nkowitt/ECrypt_analog_arms_control/README.md

# ECrypt_analog_arms_control
Design documentation for the analog information barrier circuit and data described in Warhead Verification with Neutron Beams and an
Analog Information Barrier.
