nkowitt/ECrypt_analog_arms_control/ECrypt_RevC.pdf

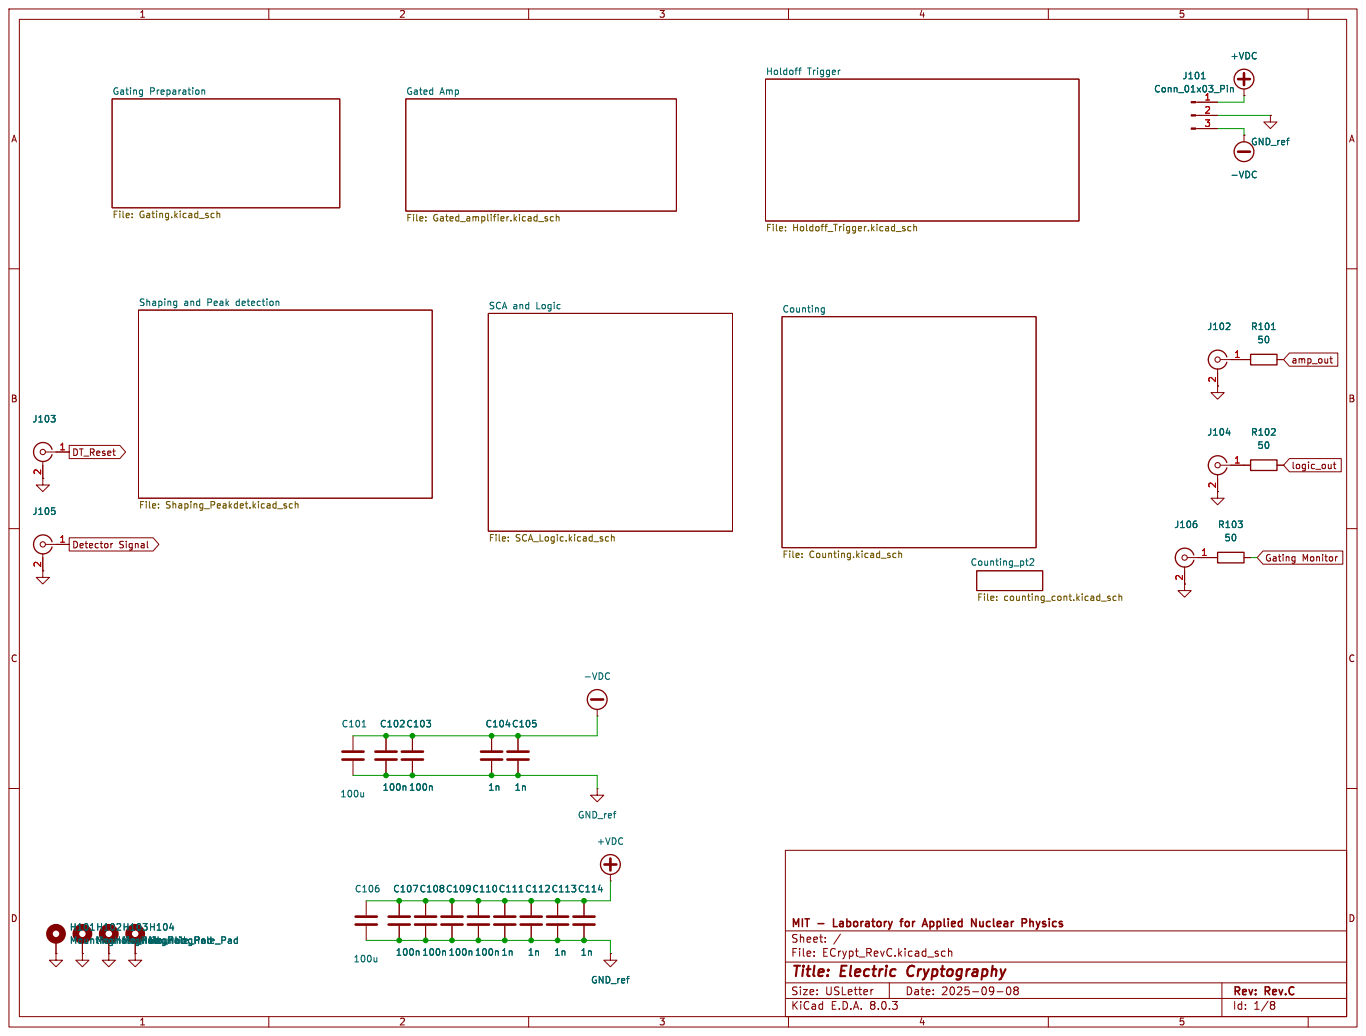
[picture p1: page 1]

Gating Preparation File: Gating.kicad_sch

Counting File: Counting.kicad_sch SCA and Logic File: SCA_Logic.kicad_sch

Id: 1/8 Title: Electric Cryptography

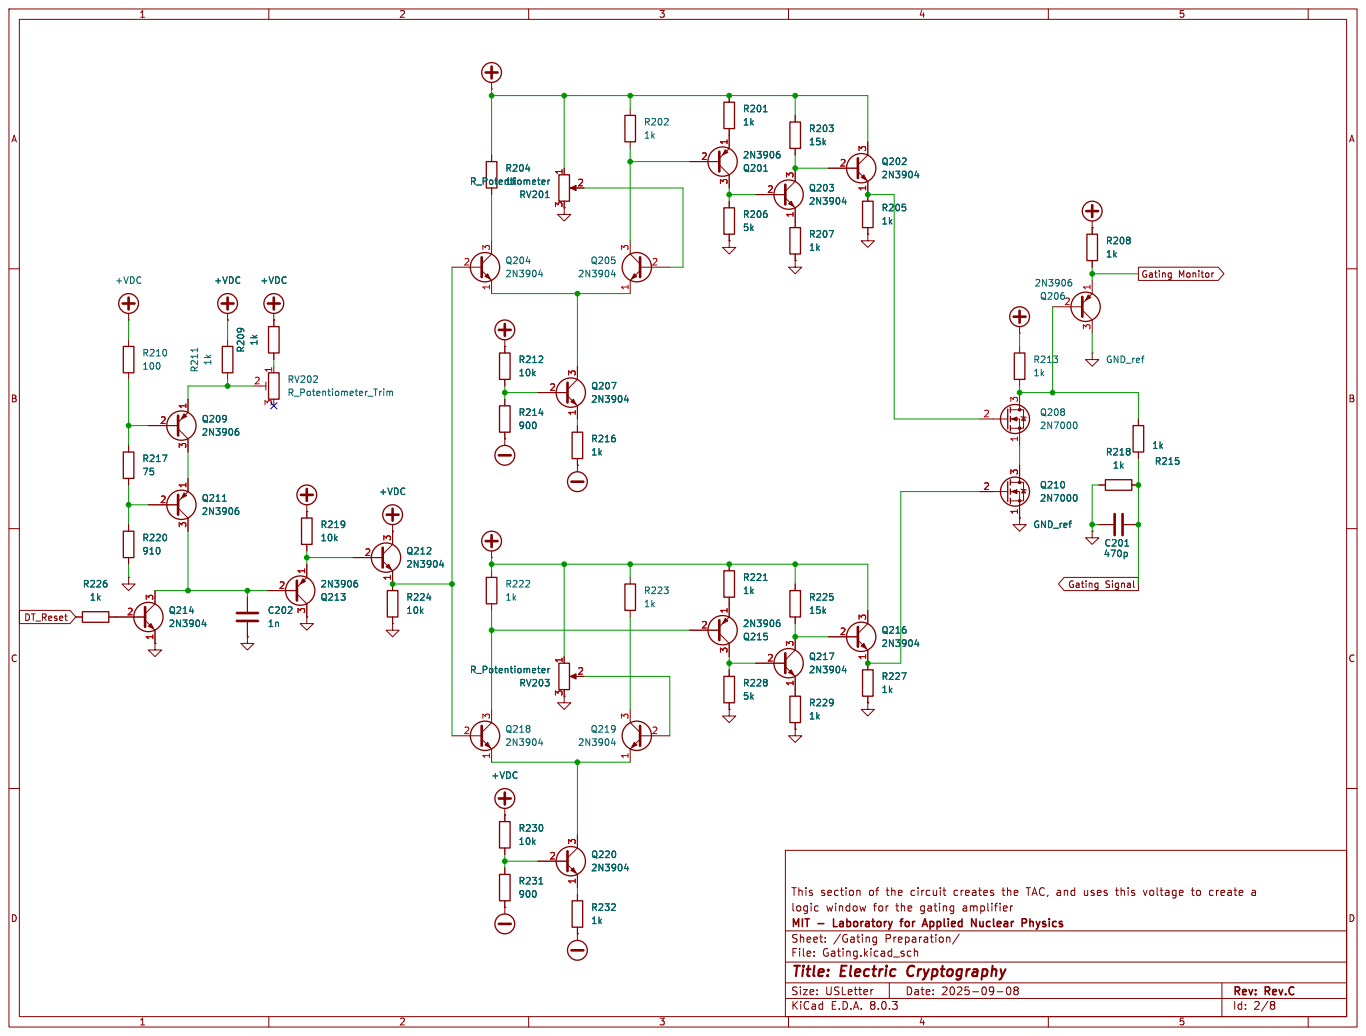
[picture p2: page 2]

Id: 2/8 Title: Electric Cryptography

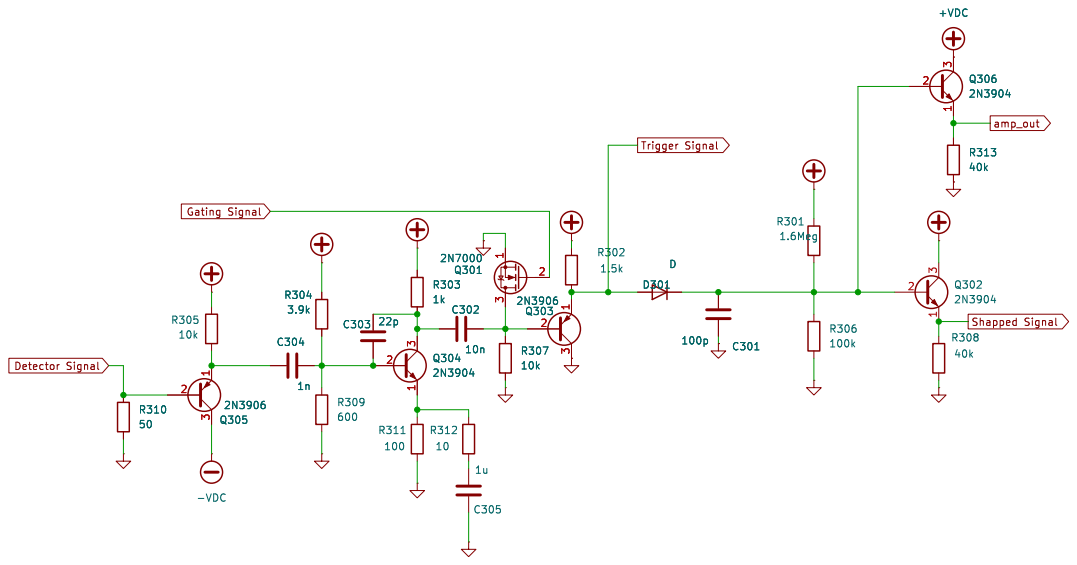
[picture p3: page 3]

Id: 3/8 Title: Electric Cryptography

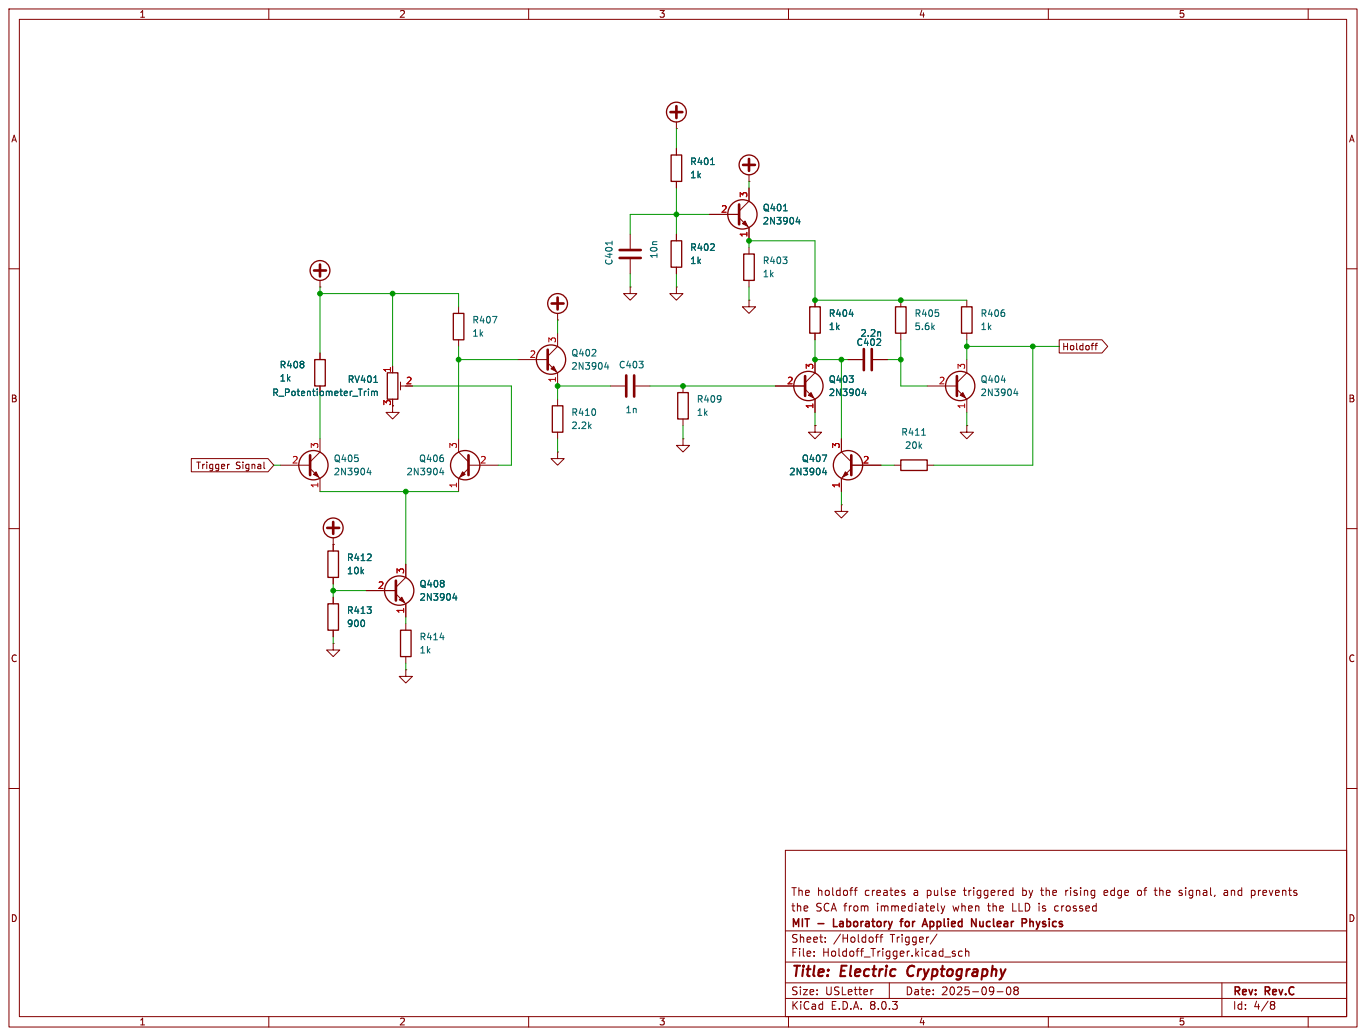
[picture p4: page 4]

Id: 4/8 Title: Electric Cryptography

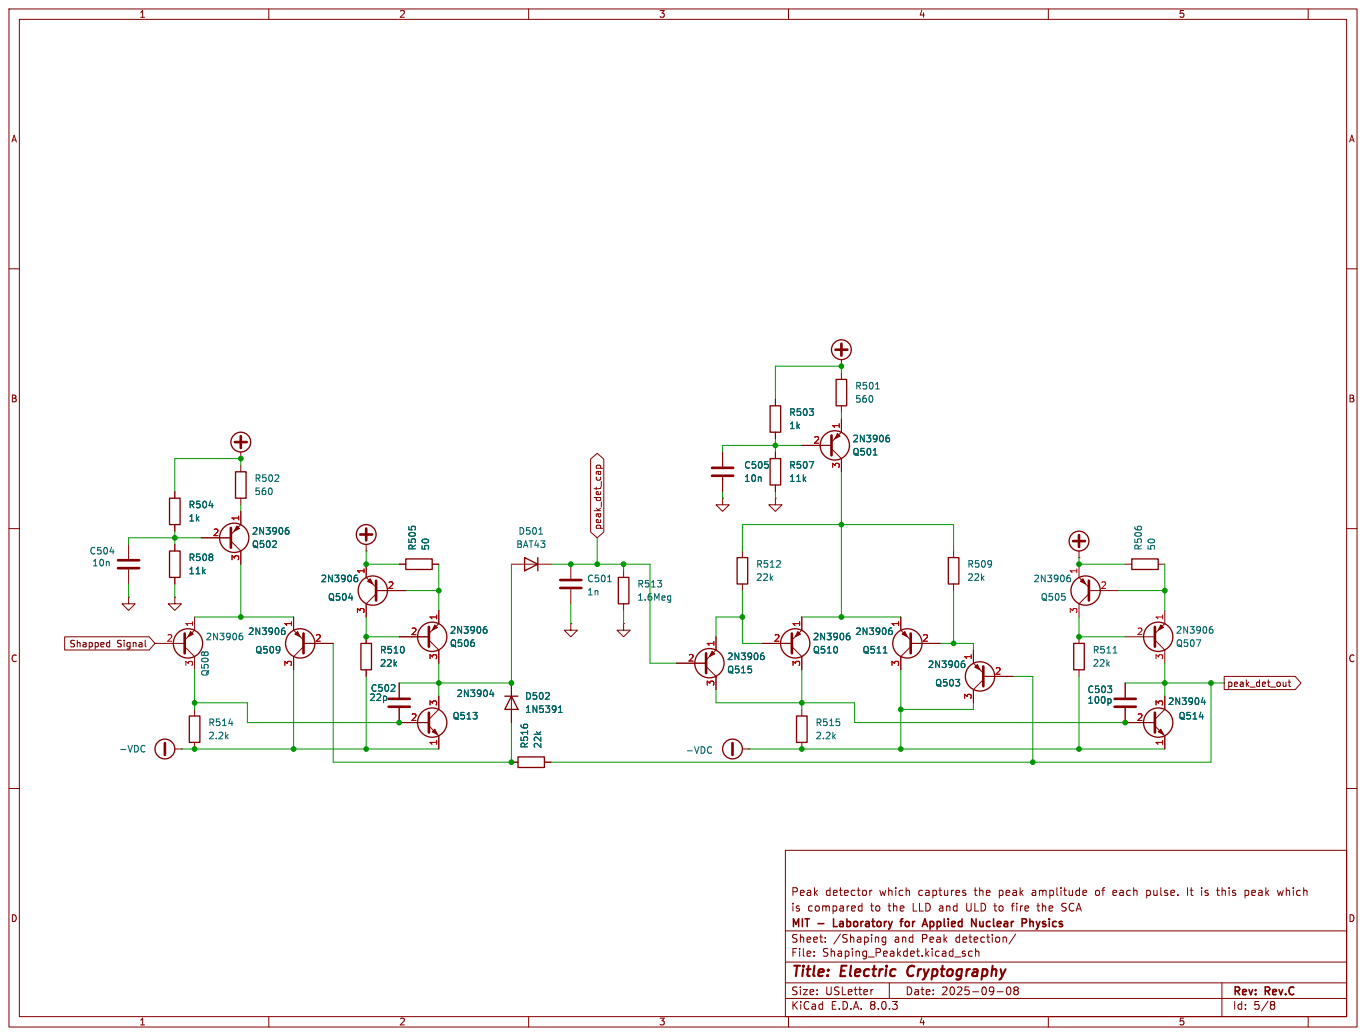
[picture p5: page 5]

Id: 5/8 Title: Electric Cryptography

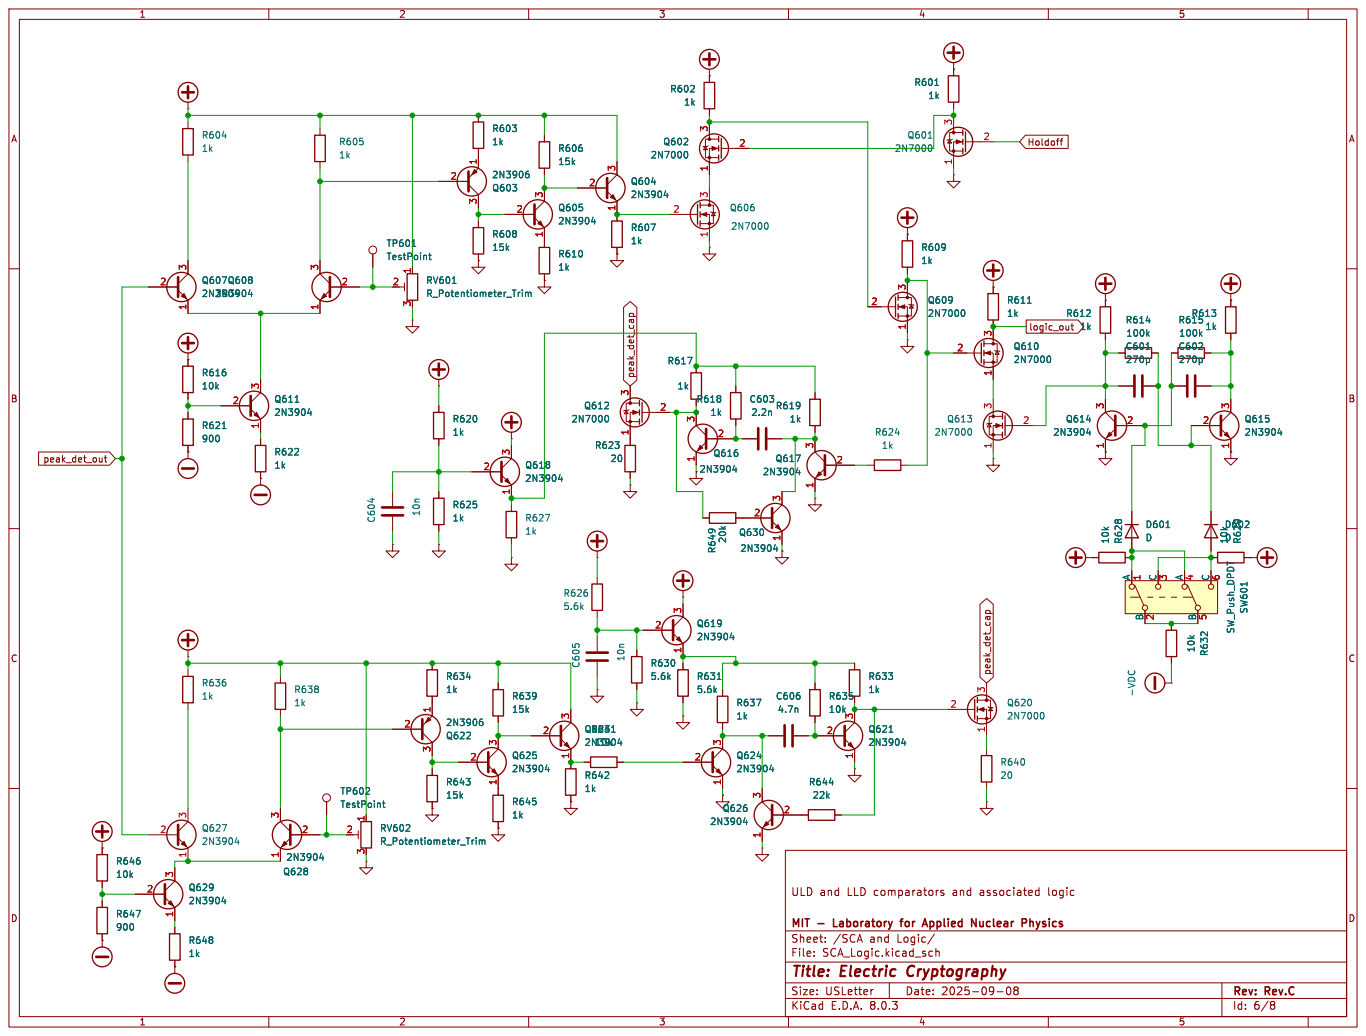
[picture p6: page 6]

Id: 6/8 Title: Electric Cryptography

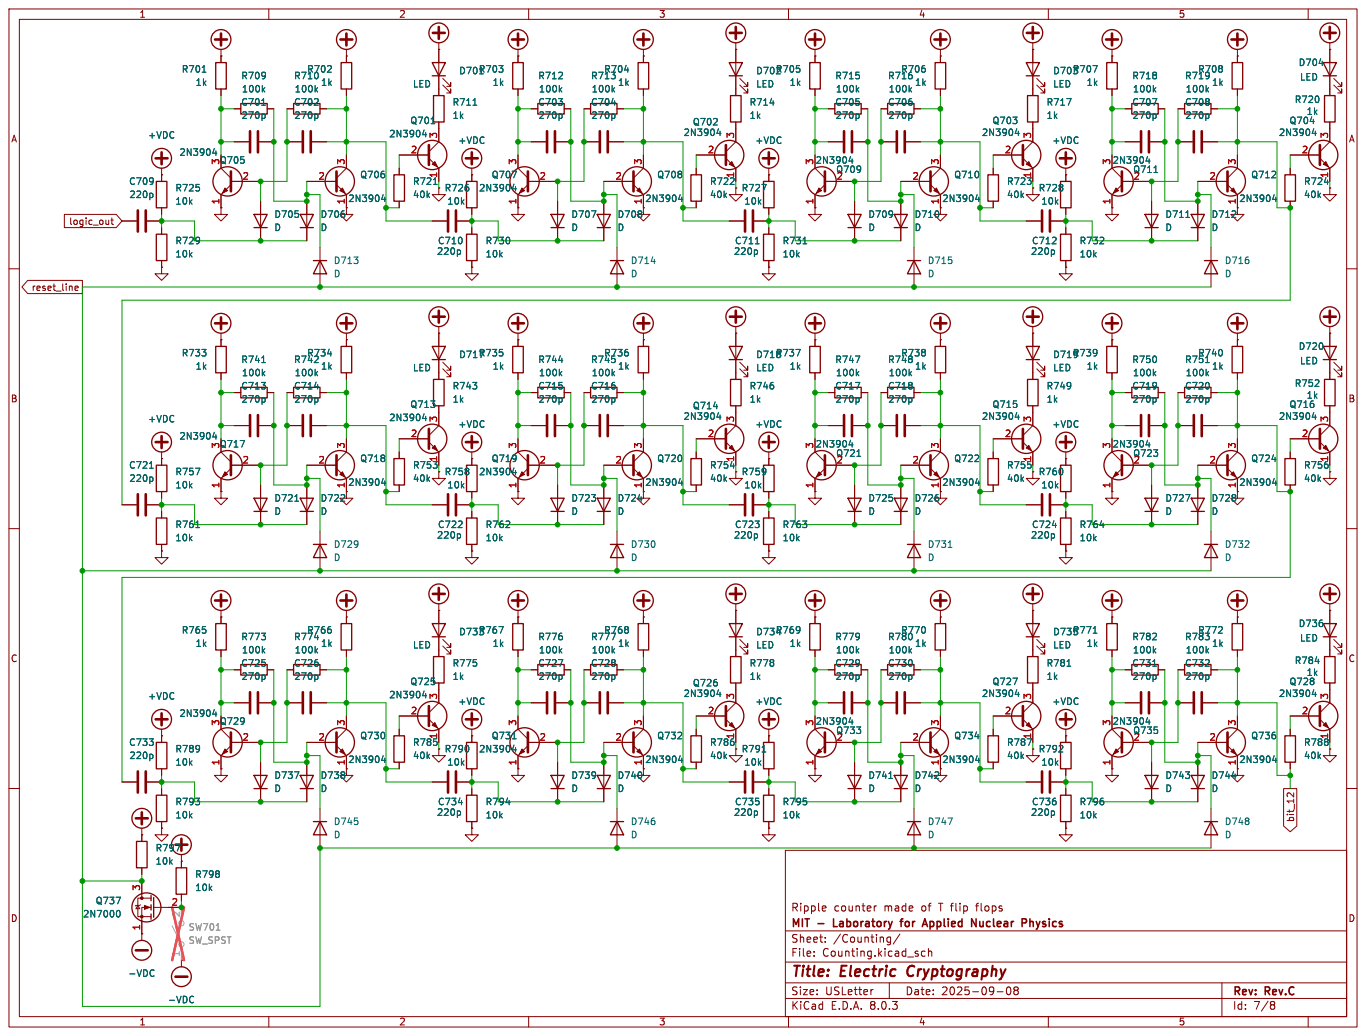
[picture p7: page 7]

Id: 7/8 Title: Electric Cryptography

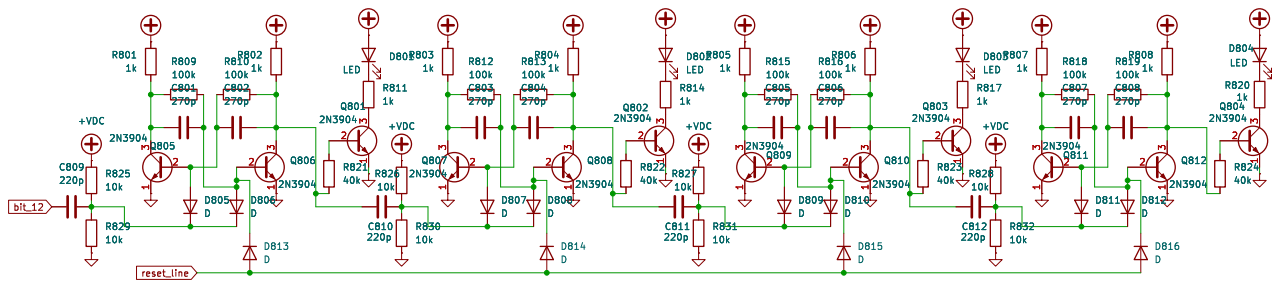
[picture p8: page 8]

Id: 8/8 Title: Electric Cryptography
