nkowitt/ECrypt_analog_arms_control/pcb_design/ECrypt_RevC.kicad_pcb

## KiCad design pcb_design/ECrypt_RevC.kicad_pcb (2026-04-10)

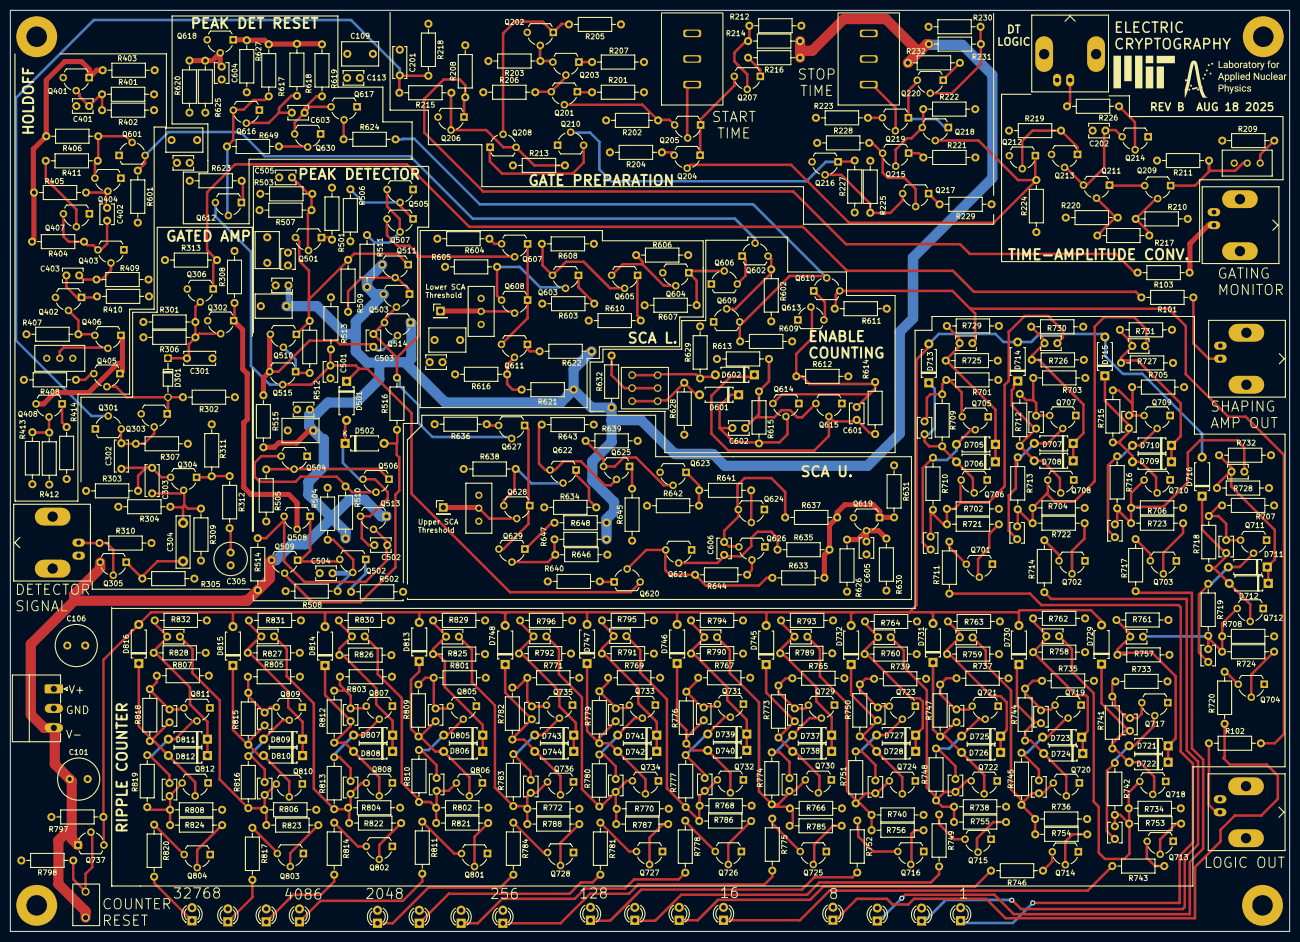
[picture p9: board ECrypt_RevC.kicad_pcb from above]

Board: 4 copper layers, 250.0 x 180.0 mm, 556 parts (0 on the bottom side), 266 nets.

Parts:
C101, C106: 100u; C_Radial_D8.0mm_H7.0mm_P3.50mm
C102, C103, C107, C108, C109, C110: 100n; C_Rect_L7.0mm_W4.5mm_P5.00mm
C104, C105, C111, C112, C113, C114, C202, C403, C501: 1n; C_Disc_D3.8mm_W2.6mm_P2.50mm
C201: 470p; C_Disc_D6.0mm_W2.5mm_P5.00mm
C301: 100p; C_Disc_D6.0mm_W2.5mm_P5.00mm
C302: 10n; C_Disc_D6.0mm_W2.5mm_P5.00mm
C303: 22p; C_Disc_D6.0mm_W2.5mm_P5.00mm
C304: 1n; C_Rect_L10.0mm_W2.5mm_P7.50mm_MKS4
C305: 1u; C_Radial_D6.3mm_H5.0mm_P2.50mm
C401, C504, C505, C604, C605: 10n; C_Disc_D3.8mm_W2.6mm_P2.50mm
C402, C603: 2.2n; C_Disc_D3.8mm_W2.6mm_P2.50mm
C502: 22p; C_Disc_D3.8mm_W2.6mm_P2.50mm
C503: 100p; C_Disc_D3.8mm_W2.6mm_P2.50mm
C601, C602, C701, C702, C703, C704, C705, C706, C707, C708, C713, C714, C715, C716, C717, C718, C719, C720, C725, C726, C727, C728, C729, C730, C731, C732, C801, C802, C803, C804, C805, C806, C807, C808: 270p; C_Disc_D3.8mm_W2.6mm_P2.50mm
C606: 4.7n; C_Disc_D3.8mm_W2.6mm_P2.50mm
C709, C710, C711, C712, C721, C722, C723, C724, C733, C734, C735, C736, C809, C810, C811, C812: 220p; C_Disc_D3.8mm_W2.6mm_P2.50mm
D301: D; D_DO-34_SOD68_P7.62mm_Horizontal
D501, D502, D601, D602, D705, D706, D707, D708, D709, D710, D711, D712, D713, D714, D715, D716, D721, D722, D723, D724, D725, D726, D727, D728, D729, D730, D731, D732, D737, D738, D739, D740, D741, D742, D743, D744, D745, D746, D747, D748, D805, D806, D807, D808, D809, D810, D811, D812, D813, D814, D815, D816: D; D_A-405_P7.62mm_Horizontal
D701, D702, D703, D704, D717, D718, D719, D720, D733, D734, D735, D736, D801, D802, D803, D804: LED; LED_D3.0mm
H101, H102, H103, H104: MountingHole_Pad; MountingHole_4mm_Pad
J101: Conn_01x03_Pin; PhoenixContact_MC_1,5_3-G-3.81_1x03_P3.81mm_Horizontal
J102, J103, J104, J105, J106: Conn_Coaxial; BNC_Amphenol_B6252HB-NPP3G-50_Horizontal
Q201, Q206, Q209, Q211, Q213, Q215, Q303, Q305, Q501, Q502, Q503, Q504, Q505, Q506, Q507, Q508, Q509, Q510, Q511, Q515, Q603, Q622: 2N3906; TO-92L_Wide
Q202, Q203, Q204, Q205, Q207, Q212, Q214, Q216, Q217, Q218, Q219, Q220, Q302, Q304, Q306, Q401, Q402, Q403, Q404, Q405, Q406, Q407, Q408, Q513, Q514, Q604, Q605, Q607, Q608, Q611, Q614, Q615, Q616, Q617, Q618, Q619, Q621, Q623, Q624, Q625, Q626, Q627, Q628, Q629, Q630, Q701, Q702, Q703, Q704, Q705, Q706, Q707, Q708, Q709, Q710, Q711, Q712, Q713, Q714, Q715, Q716, Q717, Q718, Q719, Q720, Q721, Q722, Q723, Q724, Q725, Q726, Q727, Q728, Q729, Q730, Q731, Q732, Q733, Q734, Q735, Q736, Q801, Q802, Q803, Q804, Q805, Q806, Q807, Q808, Q809, Q810, Q811, Q812: 2N3904; TO-92L_Wide
Q208, Q210, Q301, Q601, Q602, Q606, Q609, Q610, Q612, Q613, Q620, Q737: 2N7000; TO-92L_Wide
R101, R102, R103, R310, R505, R506: 50; R_Axial_DIN0207_L6.3mm_D2.5mm_P10.16mm_Horizontal
R201, R202, R204, R205, R207, R208, R209, R211, R213, R215, R216, R218, R221, R222, R223, R226, R227, R229, R232, R303, R401, R402, R403, R404, R406, R409, R414, R501, R502, R503, R504, R601, R602, R603, R607, R609, R610, R611, R612, R613, R617, R618, R619, R620, R622, R624, R625, R627, R633, R634, R637, R642, R645, R648, R701, R702, R703, R704, R705, R706, R707, R708, R711, R714, R717, R720, R733, R734, R735, R736, R737, R738, R739, R740, R743, R746, R749, R752, R765, R766, R767, R768, R769, R770, R771, R772, R775, R778, R781, R784, R801, R802, R803, R804, R805, R806, R807, R808, R811, R814, R817, R820: 1k; R_Axial_DIN0207_L6.3mm_D2.5mm_P10.16mm_Horizontal
R203, R225, R606, R608, R639, R643: 15k; R_Axial_DIN0207_L6.3mm_D2.5mm_P10.16mm_Horizontal
R206, R228: 5k; R_Axial_DIN0207_L6.3mm_D2.5mm_P10.16mm_Horizontal
R210, R311: 100; R_Axial_DIN0207_L6.3mm_D2.5mm_P10.16mm_Horizontal
R212, R219, R224, R230, R305, R307, R412, R604, R605, R616, R628, R629, R632, R635, R636, R638, R641, R646, R725, R726, R727, R728, R729, R730, R731, R732, R757, R758, R759, R760, R761, R762, R763, R764, R789, R790, R791, R792, R793, R794, R795, R796, R797, R798, R825, R826, R827, R828, R829, R830, R831, R832: 10k; R_Axial_DIN0207_L6.3mm_D2.5mm_P10.16mm_Horizontal
R214, R231, R413, R621, R647: 900; R_Axial_DIN0207_L6.3mm_D2.5mm_P10.16mm_Horizontal
R217: 75; R_Axial_DIN0207_L6.3mm_D2.5mm_P10.16mm_Horizontal
R220: 910; R_Axial_DIN0207_L6.3mm_D2.5mm_P10.16mm_Horizontal
R301: 2Meg; R_Axial_DIN0207_L6.3mm_D2.5mm_P10.16mm_Horizontal
R302: 1.5k; R_Axial_DIN0207_L6.3mm_D2.5mm_P10.16mm_Horizontal
R304: 3.9k; R_Axial_DIN0207_L6.3mm_D2.5mm_P10.16mm_Horizontal
R306, R614, R615, R709, R710, R712, R713, R715, R716, R718, R719, R741, R742, R744, R745, R747, R748, R750, R751, R773, R774, R776, R777, R779, R780, R782, R783, R809, R810, R812, R813, R815, R816, R818, R819: 100k; R_Axial_DIN0207_L6.3mm_D2.5mm_P10.16mm_Horizontal
R308, R313, R721, R722, R723, R724, R753, R754, R755, R756, R785, R786, R787, R788, R821, R822, R823, R824: 40k; R_Axial_DIN0207_L6.3mm_D2.5mm_P10.16mm_Horizontal
R309: 600; R_Axial_DIN0207_L6.3mm_D2.5mm_P10.16mm_Horizontal
R312: 10; R_Axial_DIN0207_L6.3mm_D2.5mm_P10.16mm_Horizontal
R405, R407, R408, R626, R630, R631: 5.6k; R_Axial_DIN0207_L6.3mm_D2.5mm_P10.16mm_Horizontal
R410, R514, R515: 2.2k; R_Axial_DIN0207_L6.3mm_D2.5mm_P10.16mm_Horizontal
R411, R649: 20k; R_Axial_DIN0207_L6.3mm_D2.5mm_P10.16mm_Horizontal
R507, R508: 11k; R_Axial_DIN0207_L6.3mm_D2.5mm_P10.16mm_Horizontal
R509, R510, R511, R512, R516, R644: 22k; R_Axial_DIN0207_L6.3mm_D2.5mm_P10.16mm_Horizontal
R513: 1Meg; R_Axial_DIN0207_L6.3mm_D2.5mm_P10.16mm_Horizontal
R623, R640: 20; R_Axial_DIN0207_L6.3mm_D2.5mm_P10.16mm_Horizontal
RV201, RV203: R_Potentiometer; Bourns 3590s
RV202, RV401, RV601, RV602: R_Potentiometer_Trim; Potentiometer_Bourns_3296W_Vertical
SW601: SW_Push_DPDT; SW_CK_JS202011CQN_DPDT_Straight
SW701: SW_SPST; SW_DIP_SPSTx01_Piano_10.8x4.1mm_W7.62mm_P2.54mm
TP601: TestPoint; PinHeader_1x01_P2.54mm_Vertical
Upper threshold: TestPoint; PinHeader_1x01_P2.54mm_Vertical

Connections:
+VDC: C106.1, C107.1, C108.1, C109.1, C110.1, C111.1, C112.1, C113.1, C114.1, D701.2 (A), D702.2 (A), D703.2 (A), D704.2 (A), D717.2 (A), D718.2 (A), D719.2 (A), D720.2 (A), D733.2 (A), D734.2 (A), D735.2 (A), D736.2 (A), D801.2 (A), D802.2 (A), D803.2 (A), D804.2 (A), J101.1, Q202.3 (C), Q212.3 (C), Q216.3 (C), Q302.3 (C), Q306.3 (C), Q401.3 (C), Q402.3 (C), Q504.1 (E), Q505.1 (E), Q604.3 (C), Q618.3 (C), Q619.3 (C), Q623.3 (C), R201.2, R202.2, R203.2, R204.2, R208.2, R209.2, R210.2, R211.2, R212.2, R213.1, R219.2, R221.2, R222.2, R223.2, R225.2, R230.2, R301.1, R302.1, R303.1, R304.1, R305.1, R401.2, R407.2, R408.2, R412.2, R501.1, R502.1, R503.1, R504.1, R505.1, R506.1, R601.2, R602.2, R603.2, R604.2, R605.2, R606.2, R609.2, R611.2, R612.2, R613.2, R616.2, R620.2, R626.2, R628.1, R629.2, R634.2, R636.2, R638.2, R639.2, R646.2, R701.2, R702.2, R703.2, R704.2, R705.2, R706.2, R707.2, R708.2, R725.2, R726.2, R727.2, R728.2, R733.2, R734.2, R735.2, R736.2, R737.2, R738.2, R739.2, R740.2, R757.2, R758.2, R759.2, R760.2, R765.2, R766.2, R767.2, R768.2, R769.2, R770.2, R771.2, R772.2, R789.2, R790.2, R791.2, R792.2, R797.2, R798.2, R801.2, R802.2, R803.2, R804.2, R805.2, R806.2, R807.2, R808.2, R825.2, R826.2, R827.2, R828.2, RV201.1, RV203.1, RV401.1, RV601.1, RV602.1
-VDC: C101.1, C102.1, C103.1, C104.1, C105.1, J101.3, Q305.3 (C), Q503.3 (C), Q509.3 (C), Q511.3 (C), Q513.1 (E), Q514.1 (E), Q737.1 (S), R214.1, R216.1, R231.1, R232.1, R510.2, R511.2, R514.2, R515.2, R621.1, R622.1, R632.1, R647.1, R648.1, SW701.1 (A)
DT_Reset: J103.1 (In), R226.1
Detector Signal: J105.1 (In), Q305.2 (B), R310.1
GND_ref: C101.2, C102.2, C103.2, C104.2, C105.2, C106.2, C107.2, C108.2, C109.2, C110.2, C111.2, C112.2, C113.2, C114.2, C201.1, C202.2, C301.1, C305.1, C401.2, C501.2, C504.2, C505.2, C604.2, C605.2, H101.1, H102.1, H103.1, H104.1, J101.2, J102.2 (Ext), J103.2 (Ext), J104.2 (Ext), J105.2 (Ext), J106.2 (Ext), Q206.3 (C), Q210.1 (S), Q213.3 (C), Q214.1 (E), Q301.1 (S), Q303.3 (C), Q403.1 (E), Q404.1 (E), Q407.1 (E), Q601.1 (S), Q606.1 (S), Q609.1 (S), Q613.1 (S), Q614.1 (E), Q615.1 (E), Q616.1 (E), Q617.1 (E), Q621.1 (E), Q624.1 (E), Q626.1 (E), Q630.1 (E), Q701.1 (E), Q702.1 (E), Q703.1 (E), Q704.1 (E), Q705.1 (E), Q706.1 (E), Q707.1 (E), Q708.1 (E), Q709.1 (E), Q710.1 (E), Q711.1 (E), Q712.1 (E), Q713.1 (E), Q714.1 (E), Q715.1 (E), Q716.1 (E), Q717.1 (E), Q718.1 (E), Q719.1 (E), Q720.1 (E), Q721.1 (E), Q722.1 (E), Q723.1 (E), Q724.1 (E), Q725.1 (E), Q726.1 (E), Q727.1 (E), Q728.1 (E), Q729.1 (E), Q730.1 (E), Q731.1 (E), Q732.1 (E), Q733.1 (E), Q734.1 (E), Q735.1 (E), Q736.1 (E), Q801.1 (E), Q802.1 (E), Q803.1 (E), Q804.1 (E), Q805.1 (E), Q806.1 (E), Q807.1 (E), Q808.1 (E), Q809.1 (E), Q810.1 (E), Q811.1 (E), Q812.1 (E), R205.1, R206.1, R207.1, R218.1, R220.1, R224.1, R227.1, R228.1, R229.1, R306.2, R307.2, R308.2, R309.2, R310.2, R311.2, R313.1, R402.1, R403.1, R409.1, R410.1, R413.1, R414.1, R507.2, R508.2, R513.2, R607.1, R608.1, R610.1, R623.1, R625.1, R627.1, R630.1, R631.1, R640.1, R642.1, R643.1, R645.1, R729.1, R730.1, R731.1, R732.1, R761.1, R762.1, R763.1, R764.1, R793.1, R794.1, R795.1, R796.1, R829.1, R830.1, R831.1, R832.1, RV201.3, RV203.3, RV401.3, RV601.3, RV602.3
Gating Monitor: Q206.1 (E), R103.2, R208.1
Gating Signal: C201.2, Q301.2 (G), R215.2, R218.2
Holdoff: Q404.3 (C), Q601.2 (G), R406.1, R411.1
unnamed: C305.2, R312.2
unnamed: C301.2, D301.1 (K), Q302.2 (B), Q306.2 (B), R301.2, R306.1
unnamed: C502.1, D501.2 (A), D502.1 (K), Q506.3 (C), Q513.3 (C)
unnamed: D502.2 (A), Q509.2 (B), R516.1
unnamed: D601.2 (A), R628.2, SW601.1 (A), SW601.4 (A)
unnamed: C602.2, D601.1 (K), Q614.2 (B), R615.1
unnamed: D602.2 (A), R629.1, SW601.3 (C), SW601.6 (C)
unnamed: C601.1, D602.1 (K), Q615.2 (B), R614.2
unnamed: D701.1 (K), R711.2
unnamed: D702.1 (K), R714.2
unnamed: D703.1 (K), R717.2
unnamed: D704.1 (K), R720.2
unnamed: C702.2, D705.2 (A), Q705.2 (B), R710.1
unnamed: C709.2, D705.1 (K), D706.1 (K), R725.1, R729.2
unnamed: C701.1, D706.2 (A), D713.1 (K), Q706.2 (B), R709.2
unnamed: C704.2, D707.2 (A), Q707.2 (B), R713.1
unnamed: C710.2, D707.1 (K), D708.1 (K), R726.1, R730.2
unnamed: C703.1, D708.2 (A), D714.1 (K), Q708.2 (B), R712.2
unnamed: C706.2, D709.2 (A), Q709.2 (B), R716.1
unnamed: C711.2, D709.1 (K), D710.1 (K), R727.1, R731.2
unnamed: C705.1, D710.2 (A), D715.1 (K), Q710.2 (B), R715.2
unnamed: C708.2, D711.2 (A), Q711.2 (B), R719.1
unnamed: C712.2, D711.1 (K), D712.1 (K), R728.1, R732.2
unnamed: C707.1, D712.2 (A), D716.1 (K), Q712.2 (B), R718.2
unnamed: D717.1 (K), R743.2
unnamed: D718.1 (K), R746.2
unnamed: D719.1 (K), R749.2
unnamed: D720.1 (K), R752.2
unnamed: C714.2, D721.2 (A), Q717.2 (B), R742.1
unnamed: C721.2, D721.1 (K), D722.1 (K), R757.1, R761.2
unnamed: C713.1, D722.2 (A), D729.1 (K), Q718.2 (B), R741.2
unnamed: C716.2, D723.2 (A), Q719.2 (B), R745.1
unnamed: C722.2, D723.1 (K), D724.1 (K), R758.1, R762.2
unnamed: C715.1, D724.2 (A), D730.1 (K), Q720.2 (B), R744.2
unnamed: C718.2, D725.2 (A), Q721.2 (B), R748.1
unnamed: C723.2, D725.1 (K), D726.1 (K), R759.1, R763.2
unnamed: C717.1, D726.2 (A), D731.1 (K), Q722.2 (B), R747.2
unnamed: C720.2, D727.2 (A), Q723.2 (B), R751.1
unnamed: C724.2, D727.1 (K), D728.1 (K), R760.1, R764.2
unnamed: C719.1, D728.2 (A), D732.1 (K), Q724.2 (B), R750.2
unnamed: D733.1 (K), R775.2
unnamed: D734.1 (K), R778.2
unnamed: D735.1 (K), R781.2
unnamed: D736.1 (K), R784.2
unnamed: C726.2, D737.2 (A), Q729.2 (B), R774.1
unnamed: C733.2, D737.1 (K), D738.1 (K), R789.1, R793.2
unnamed: C725.1, D738.2 (A), D745.1 (K), Q730.2 (B), R773.2
unnamed: C728.2, D739.2 (A), Q731.2 (B), R777.1
unnamed: C734.2, D739.1 (K), D740.1 (K), R790.1, R794.2
unnamed: C727.1, D740.2 (A), D746.1 (K), Q732.2 (B), R776.2
unnamed: C730.2, D741.2 (A), Q733.2 (B), R780.1
unnamed: C735.2, D741.1 (K), D742.1 (K), R791.1, R795.2
unnamed: C729.1, D742.2 (A), D747.1 (K), Q734.2 (B), R779.2
unnamed: C732.2, D743.2 (A), Q735.2 (B), R783.1
unnamed: C736.2, D743.1 (K), D744.1 (K), R792.1, R796.2
unnamed: C731.1, D744.2 (A), D748.1 (K), Q736.2 (B), R782.2
unnamed: D801.1 (K), R811.2
unnamed: D802.1 (K), R814.2
unnamed: D803.1 (K), R817.2
unnamed: D804.1 (K), R820.2
unnamed: C802.2, D805.2 (A), Q805.2 (B), R810.1
unnamed: C809.2, D805.1 (K), D806.1 (K), R825.1, R829.2
unnamed: C801.1, D806.2 (A), D813.1 (K), Q806.2 (B), R809.2
unnamed: C804.2, D807.2 (A), Q807.2 (B), R813.1
unnamed: C810.2, D807.1 (K), D808.1 (K), R826.1, R830.2
unnamed: C803.1, D808.2 (A), D814.1 (K), Q808.2 (B), R812.2
unnamed: C806.2, D809.2 (A), Q809.2 (B), R816.1
unnamed: C811.2, D809.1 (K), D810.1 (K), R827.1, R831.2
unnamed: C805.1, D810.2 (A), D815.1 (K), Q810.2 (B), R815.2
unnamed: C808.2, D811.2 (A), Q811.2 (B), R819.1
unnamed: C812.2, D811.1 (K), D812.1 (K), R828.1, R832.2
unnamed: C807.1, D812.2 (A), D816.1 (K), Q812.2 (B), R818.2
unnamed: J102.1 (In), R101.1
unnamed: J104.1 (In), R102.1
unnamed: J106.1 (In), R103.1
unnamed: Q201.2 (B), Q205.3 (C), R202.1
unnamed: Q201.3 (C), Q203.2 (B), R206.2
unnamed: Q201.1 (E), R201.1
unnamed: Q202.2 (B), Q203.3 (C), R203.1
unnamed: Q202.1 (E), Q208.2 (G), R205.2
unnamed: Q203.1 (E), R207.2
unnamed: Q204.2 (B), Q212.1 (E), Q218.2 (B), R224.2
unnamed: Q204.3 (C), R204.1
unnamed: Q204.1 (E), Q205.1 (E), Q207.3 (C)
unnamed: Q205.2 (B), RV201.2
unnamed: Q206.2 (B), Q208.3 (D), R213.2, R215.1
unnamed: Q207.2 (B), R212.1, R214.2
unnamed: Q207.1 (E), R216.2
unnamed: Q208.1 (S), Q210.3 (D)
unnamed: Q209.2 (B), R210.1, R217.2
unnamed: Q209.3 (C), Q211.1 (E)
unnamed: Q209.1 (E), R211.1, RV202.2
unnamed: Q210.2 (G), Q216.1 (E), R227.2
unnamed: Q211.2 (B), R217.1, R220.2
unnamed: C202.1, Q211.3 (C), Q213.2 (B), Q214.3 (C)
unnamed: Q212.2 (B), Q213.1 (E), R219.1
unnamed: Q214.2 (B), R226.2
unnamed: Q215.2 (B), Q218.3 (C), R222.1
unnamed: Q215.3 (C), Q217.2 (B), R228.2
unnamed: Q215.1 (E), R221.1
unnamed: Q216.2 (B), Q217.3 (C), R225.1
unnamed: Q217.1 (E), R229.2
unnamed: Q218.1 (E), Q219.1 (E), Q220.3 (C)
unnamed: Q219.2 (B), RV203.2
unnamed: Q219.3 (C), R223.1
unnamed: Q220.2 (B), R230.1, R231.2
unnamed: Q220.1 (E), R232.2
unnamed: C302.2, Q301.3 (D), Q303.2 (B), R307.1
unnamed: C303.1, C304.2, Q304.2 (B), R304.2, R309.1
unnamed: C302.1, C303.2, Q304.3 (C), R303.2
unnamed: Q304.1 (E), R311.1, R312.1
unnamed: C304.1, Q305.1 (E), R305.2
unnamed: C401.1, Q401.2 (B), R401.1, R402.2
unnamed: Q401.1 (E), R403.2, R404.2, R405.2, R406.2
unnamed: Q402.2 (B), Q406.3 (C), R407.1
unnamed: C403.2, Q402.1 (E), R410.2
unnamed: C403.1, Q403.2 (B), R409.2
unnamed: C402.2, Q403.3 (C), Q407.3 (C), R404.1
unnamed: C402.1, Q404.2 (B), R405.1
unnamed: Q405.3 (C), R408.1
unnamed: Q405.1 (E), Q406.1 (E), Q408.3 (C)
unnamed: Q406.2 (B), RV401.2
unnamed: Q407.2 (B), R411.2
unnamed: Q408.2 (B), R412.1, R413.2
unnamed: Q408.1 (E), R414.2
unnamed: C505.1, Q501.2 (B), R503.2, R507.1
unnamed: Q501.3 (C), Q510.1 (E), Q511.1 (E), R509.1, R512.1
unnamed: Q501.1 (E), R501.2
unnamed: C504.1, Q502.2 (B), R504.2, R508.1
unnamed: Q502.3 (C), Q508.1 (E), Q509.1 (E)
unnamed: Q502.1 (E), R502.2
unnamed: Q503.1 (E), Q511.2 (B), R509.2
unnamed: Q504.2 (B), Q506.1 (E), R505.2
unnamed: Q504.3 (C), Q506.2 (B), R510.1
unnamed: Q505.2 (B), Q507.1 (E), R506.2
unnamed: Q505.3 (C), Q507.2 (B), R511.1
unnamed: C502.2, Q508.3 (C), Q513.2 (B), R514.1
unnamed: Q510.2 (B), Q515.1 (E), R512.2
unnamed: C503.2, Q510.3 (C), Q514.2 (B), Q515.3 (C), R515.1
unnamed: Q601.3 (D), Q602.2 (G), R601.1
unnamed: Q602.3 (D), Q609.2 (G), R602.1
unnamed: Q602.1 (S), Q606.3 (D)
unnamed: Q603.2 (B), Q608.3 (C), R605.1
unnamed: Q603.3 (C), Q605.2 (B), R608.2
unnamed: Q603.1 (E), R603.1
unnamed: Q604.2 (B), Q605.3 (C), R606.1
unnamed: Q604.1 (E), Q606.2 (G), R607.2
unnamed: Q605.1 (E), R610.2
unnamed: Q607.3 (C), R604.1
unnamed: Q607.1 (E), Q608.1 (E), Q611.3 (C)
unnamed: Q608.2 (B), RV601.2, TP601.1
unnamed: Q609.3 (D), Q610.2 (G), R609.1, R624.2
unnamed: Q610.1 (S), Q613.3 (D)
unnamed: Q611.2 (B), R616.1, R621.2
unnamed: Q611.1 (E), R622.2
unnamed: Q612.2 (G), Q616.3 (C), R617.1, R649.2
unnamed: Q612.1 (S), R623.2
unnamed: C601.2, Q613.2 (G), Q614.3 (C), R612.1, R614.1
unnamed: C602.1, Q615.3 (C), R613.1, R615.2
unnamed: C603.2, Q616.2 (B), R618.1
unnamed: Q617.2 (B), R624.1
unnamed: C603.1, Q617.3 (C), Q630.3 (C), R619.1
unnamed: C604.1, Q618.2 (B), R620.1, R625.2
unnamed: Q618.1 (E), R617.2, R618.2, R619.2, R627.2
unnamed: C605.1, Q619.2 (B), R626.1, R630.2
unnamed: Q619.1 (E), R631.2, R633.2, R635.2, R637.2
unnamed: Q620.2 (G), Q621.3 (C), R633.1, R644.1
unnamed: Q620.1 (S), R640.2
unnamed: C606.2, Q621.2 (B), R635.1
unnamed: Q622.2 (B), Q628.3 (C), R638.1
unnamed: Q622.3 (C), Q625.2 (B), R643.2
unnamed: Q622.1 (E), R634.1
unnamed: Q623.2 (B), Q625.3 (C), R639.1
unnamed: Q623.1 (E), R641.2, R642.2
unnamed: Q624.2 (B), R641.1
unnamed: C606.1, Q624.3 (C), Q626.3 (C), R637.1
unnamed: Q625.1 (E), R645.2
unnamed: Q626.2 (B), R644.2
unnamed: Q627.3 (C), R636.1
unnamed: Q627.1 (E), Q628.1 (E), Q629.3 (C)
unnamed: Q628.2 (B), RV602.2, Upper threshold.1
unnamed: Q629.2 (B), R646.1, R647.2
unnamed: Q629.1 (E), R648.2
unnamed: Q630.2 (B), R649.1
unnamed: Q701.2 (B), R721.2
unnamed: Q701.3 (C), R711.1
unnamed: Q702.2 (B), R722.2
unnamed: Q702.3 (C), R714.1
unnamed: Q703.2 (B), R723.2
unnamed: Q703.3 (C), R717.1
unnamed: Q704.2 (B), R724.2
unnamed: Q704.3 (C), R720.1
unnamed: C701.2, Q705.3 (C), R701.1, R709.1
unnamed: C702.1, C710.1, Q706.3 (C), R702.1, R710.2, R721.1
unnamed: C703.2, Q707.3 (C), R703.1, R712.1
unnamed: C704.1, C711.1, Q708.3 (C), R704.1, R713.2, R722.1
unnamed: C705.2, Q709.3 (C), R705.1, R715.1
unnamed: C706.1, C712.1, Q710.3 (C), R706.1, R716.2, R723.1
unnamed: C707.2, Q711.3 (C), R707.1, R718.1
unnamed: C708.1, C721.1, Q712.3 (C), R708.1, R719.2, R724.1
unnamed: Q713.2 (B), R753.2
unnamed: Q713.3 (C), R743.1
unnamed: Q714.2 (B), R754.2
unnamed: Q714.3 (C), R746.1
unnamed: Q715.2 (B), R755.2
unnamed: Q715.3 (C), R749.1
unnamed: Q716.2 (B), R756.2
unnamed: Q716.3 (C), R752.1
unnamed: C713.2, Q717.3 (C), R733.1, R741.1
unnamed: C714.1, C722.1, Q718.3 (C), R734.1, R742.2, R753.1
unnamed: C715.2, Q719.3 (C), R735.1, R744.1
unnamed: C716.1, C723.1, Q720.3 (C), R736.1, R745.2, R754.1
unnamed: C717.2, Q721.3 (C), R737.1, R747.1
unnamed: C718.1, C724.1, Q722.3 (C), R738.1, R748.2, R755.1
unnamed: C719.2, Q723.3 (C), R739.1, R750.1
unnamed: C720.1, C733.1, Q724.3 (C), R740.1, R751.2, R756.1
unnamed: Q725.2 (B), R785.2
unnamed: Q725.3 (C), R775.1
unnamed: Q726.2 (B), R786.2
unnamed: Q726.3 (C), R778.1
unnamed: Q727.2 (B), R787.2
unnamed: Q727.3 (C), R781.1
unnamed: Q728.2 (B), R788.2
unnamed: Q728.3 (C), R784.1
unnamed: C725.2, Q729.3 (C), R765.1, R773.1
unnamed: C726.1, C734.1, Q730.3 (C), R766.1, R774.2, R785.1
unnamed: C727.2, Q731.3 (C), R767.1, R776.1
unnamed: C728.1, C735.1, Q732.3 (C), R768.1, R777.2, R786.1
unnamed: C729.2, Q733.3 (C), R769.1, R779.1
unnamed: C730.1, C736.1, Q734.3 (C), R770.1, R780.2, R787.1
unnamed: C731.2, Q735.3 (C), R771.1, R782.1
unnamed: Q737.2 (G), R798.1, SW701.2 (B)
unnamed: Q801.2 (B), R821.2
unnamed: Q801.3 (C), R811.1
unnamed: Q802.2 (B), R822.2
unnamed: Q802.3 (C), R814.1
unnamed: Q803.2 (B), R823.2
unnamed: Q803.3 (C), R817.1
unnamed: Q804.2 (B), R824.2
unnamed: Q804.3 (C), R820.1
unnamed: C801.2, Q805.3 (C), R801.1, R809.1
unnamed: C802.1, C810.1, Q806.3 (C), R802.1, R810.2, R821.1
unnamed: C803.2, Q807.3 (C), R803.1, R812.1
unnamed: C804.1, C811.1, Q808.3 (C), R804.1, R813.2, R822.1
unnamed: C805.2, Q809.3 (C), R805.1, R815.1
unnamed: C806.1, C812.1, Q810.3 (C), R806.1, R816.2, R823.1
unnamed: C807.2, Q811.3 (C), R807.1, R818.1
unnamed: C808.1, Q812.3 (C), R808.1, R819.2, R824.1
unnamed: R209.1, RV202.1
unnamed: R632.2, SW601.2 (B), SW601.5 (B)
Shapped Signal: Q302.1 (E), Q508.2 (B), R308.1
Trigger Signal: D301.2 (A), Q303.1 (E), Q405.2 (B), R302.2
amp_out: Q306.1 (E), R101.2, R313.2
bit_12: C732.1, C809.1, Q736.3 (C), R772.1, R783.2, R788.1
logic_out: C709.1, Q610.3 (D), R102.2, R611.1
peak_det_cap: C501.1, D501.1 (K), Q515.2 (B), Q612.3 (D), Q620.3 (D), R513.1
peak_det_out: C503.1, Q503.2 (B), Q507.3 (C), Q514.3 (C), Q607.2 (B), Q627.2 (B), R516.2
reset_line: D713.2 (A), D714.2 (A), D715.2 (A), D716.2 (A), D729.2 (A), D730.2 (A), D731.2 (A), D732.2 (A), D745.2 (A), D746.2 (A), D747.2 (A), D748.2 (A), D813.2 (A), D814.2 (A), D815.2 (A), D816.2 (A), Q737.3 (D), R797.1
