nkowitt/ECrypt_analog_arms_control/(commit log)

2026-04-10 Added pcb and spice simulations
    [Counting.kicad_sch, ECrypt_RevC.kicad_pcb, ECrypt_RevC.kicad_sch, Gated_amplifier.kicad_sch, Gating.kicad_sch, Holdoff_Trigger.kicad_sch, SCA_Logic.kicad_sch, Shaping_Peakdet.kicad_sch]
2026-10-09 Raw data used for figures in both text and SI
    [Source_data.xlsx]
